assassin1th/BluetoothDecoder/device_board/plate/device_plate.step

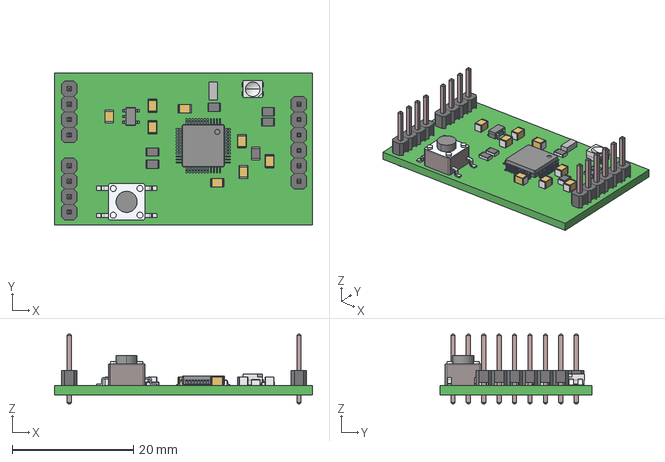
[picture p26: CAD file, 2020-04-22]
device_board/plate/device_plate.step
42.5 x 25.0 x 11.5 mm
