assassin1th/BluetoothDecoder/device_board/pattern/print_version.docx

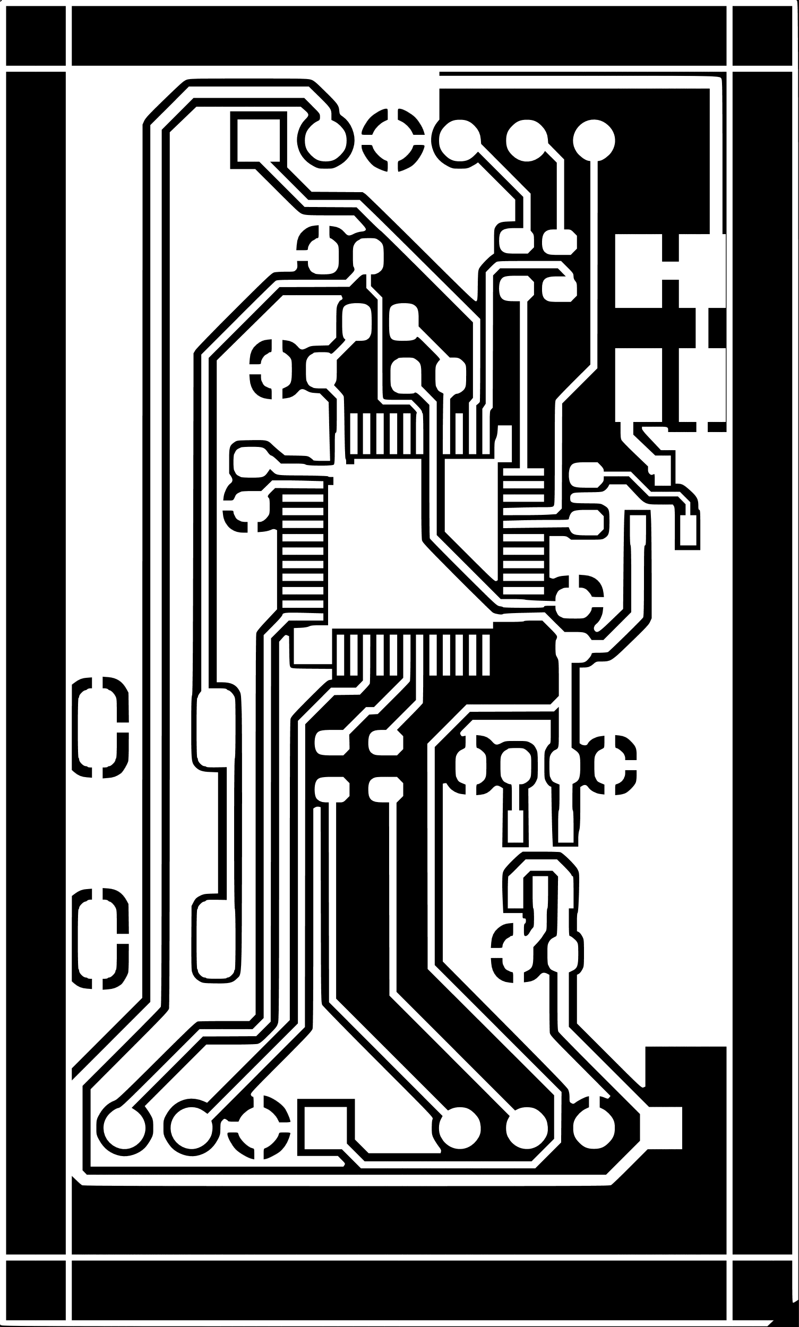
[picture p27: figure]
