assassin1th/BluetoothDecoder/documentation/drawings/Э3.pdf

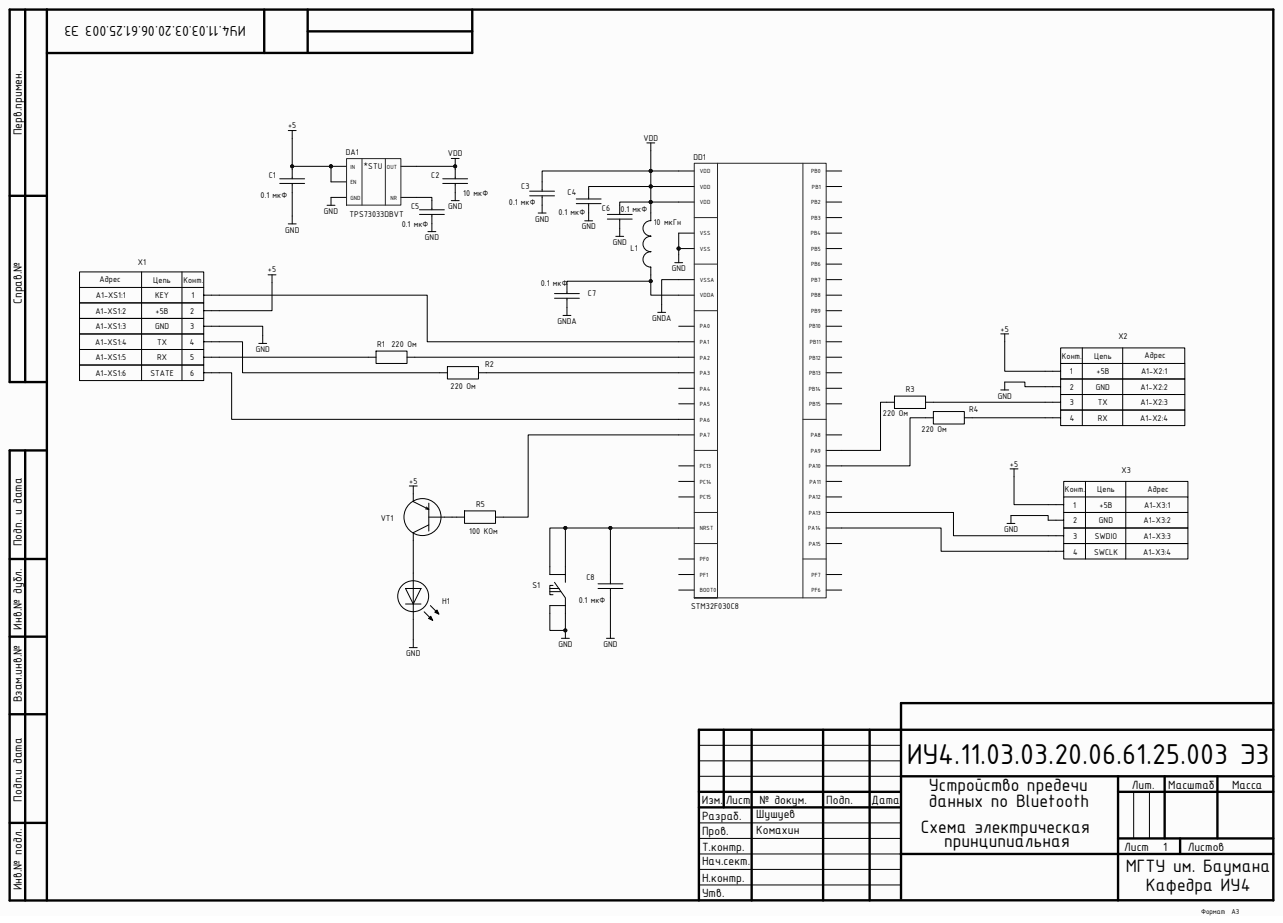
[picture p28: page 1]

Формат A3 Справ.№ Перв.примен.

A1-XS1:1 | KEY | 1
A1-XS1:2 | +5В | 2
A1-XS1:3 | GND | 3
A1-XS1:4 | TX | 4
A1-XS1:5 | RX | 5

2 | GND | A1-X2:2
3 | TX | A1-X2:3
4 | RX | A1-X2:4

Инв.№ подл. Подп.и дата Взам.инв.№ Инв.№ дубл. Подп. и дата

3 | SWDIO | A1-X3:3
4 | SWCLK | A1-X3:4

Устройство предечи данных по Bluetooth Схема электрическая принципиальная | Лит. | Масштаб | Масса

Изм. | Лист | № докум. | Подп. | Дата
Разраб. | | Шушуев
Пров. | | Комахин
Т.контр. | | | | | Лист 1 | Листов
Нач.сект. | | | | | МГТУ им. Баумана Кафедра ИУ4
Н.контр.
Утв.
