assassin1th/BluetoothDecoder/documentation/drawings/Algoritm_PO.pdf

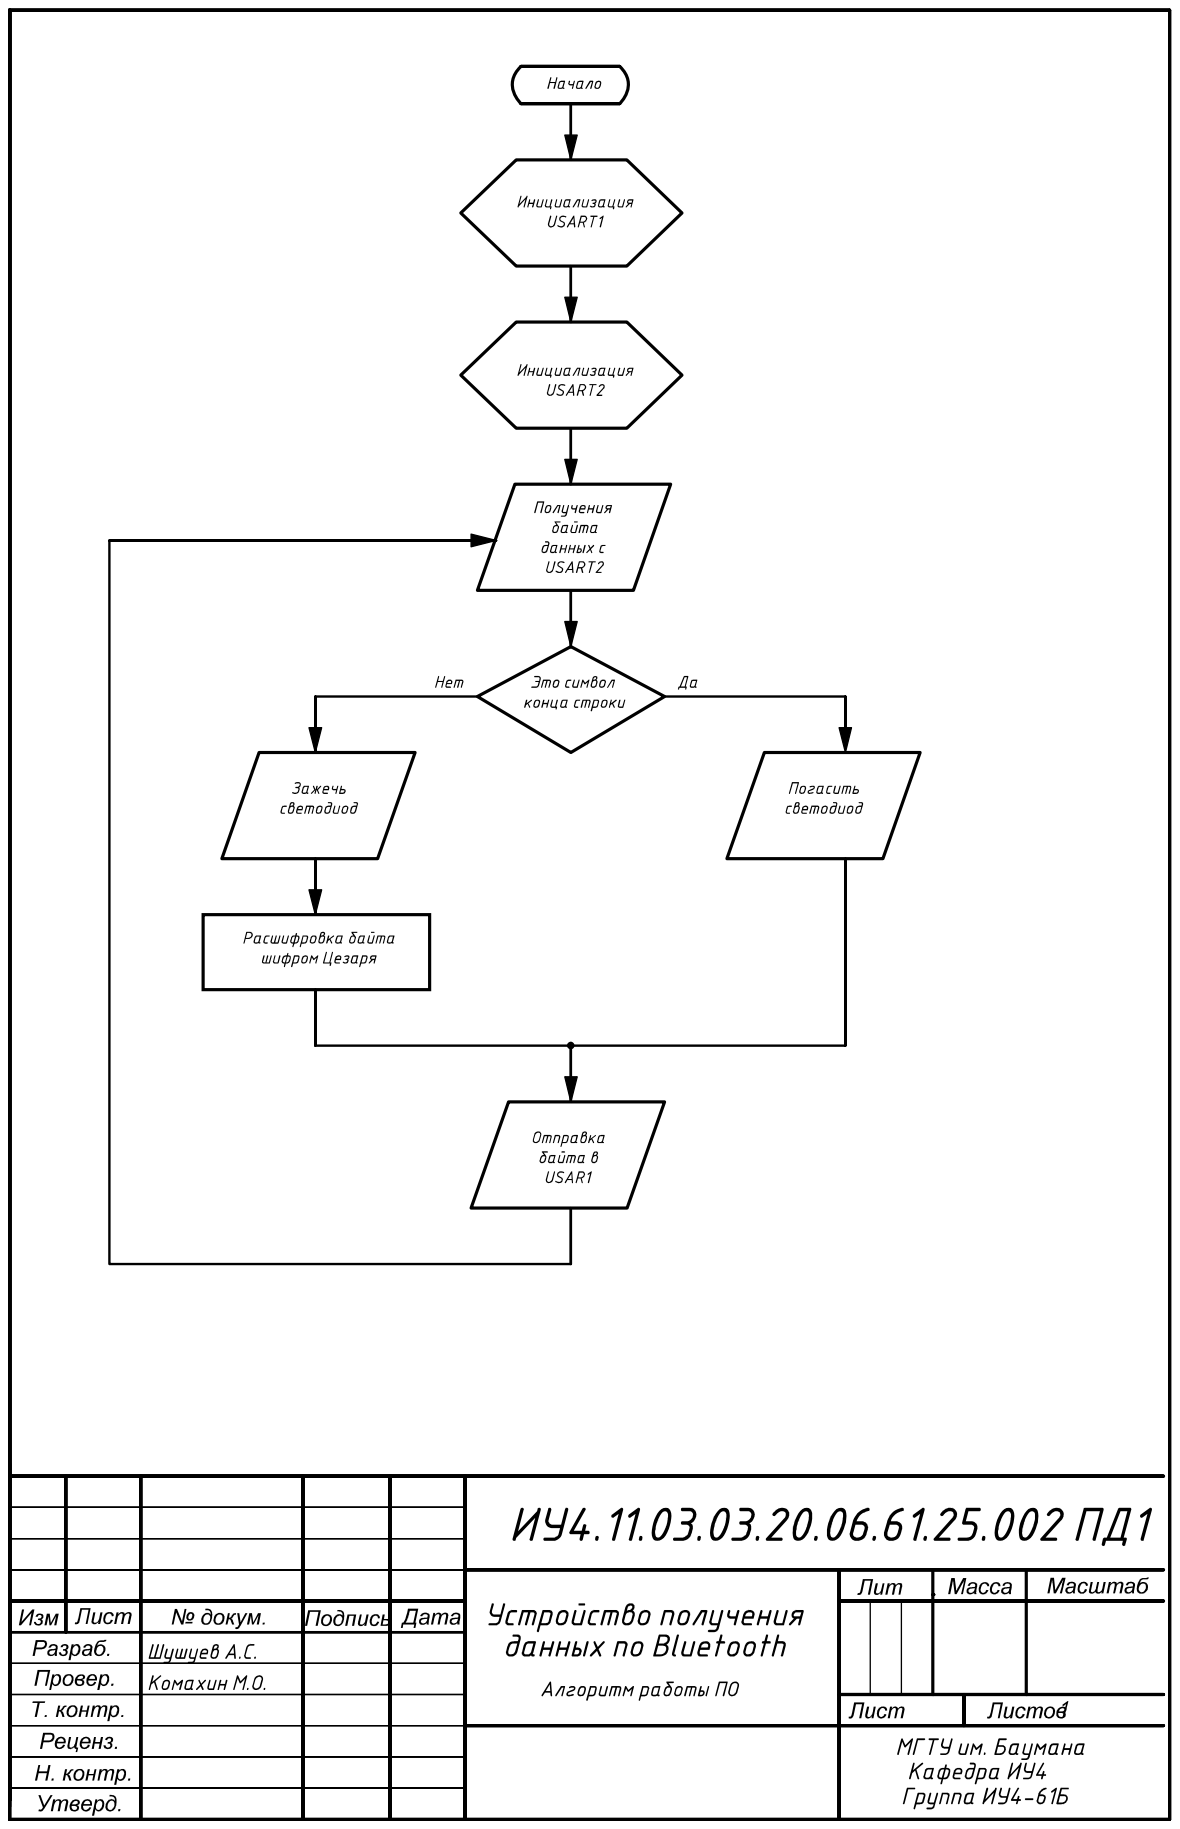
[picture p29: page 1]
