assassin1th/BluetoothDecoder/documentation/drawings/Algoritm_raboty_ustroystva.pdf

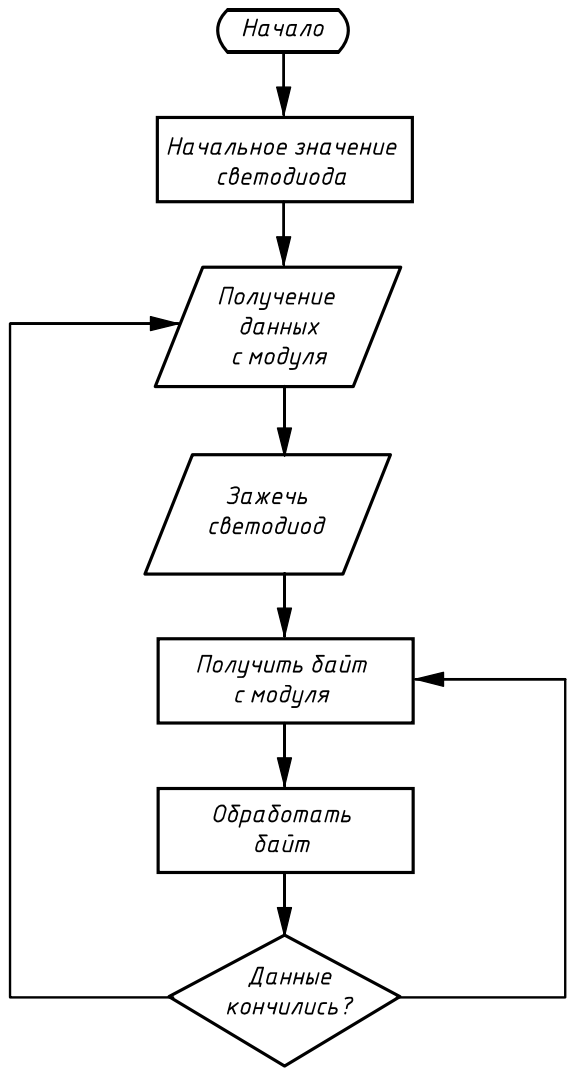
[picture p30: page 1]
