assassin1th/BluetoothDecoder/documentation/drawings/Skhema_stenda.pdf

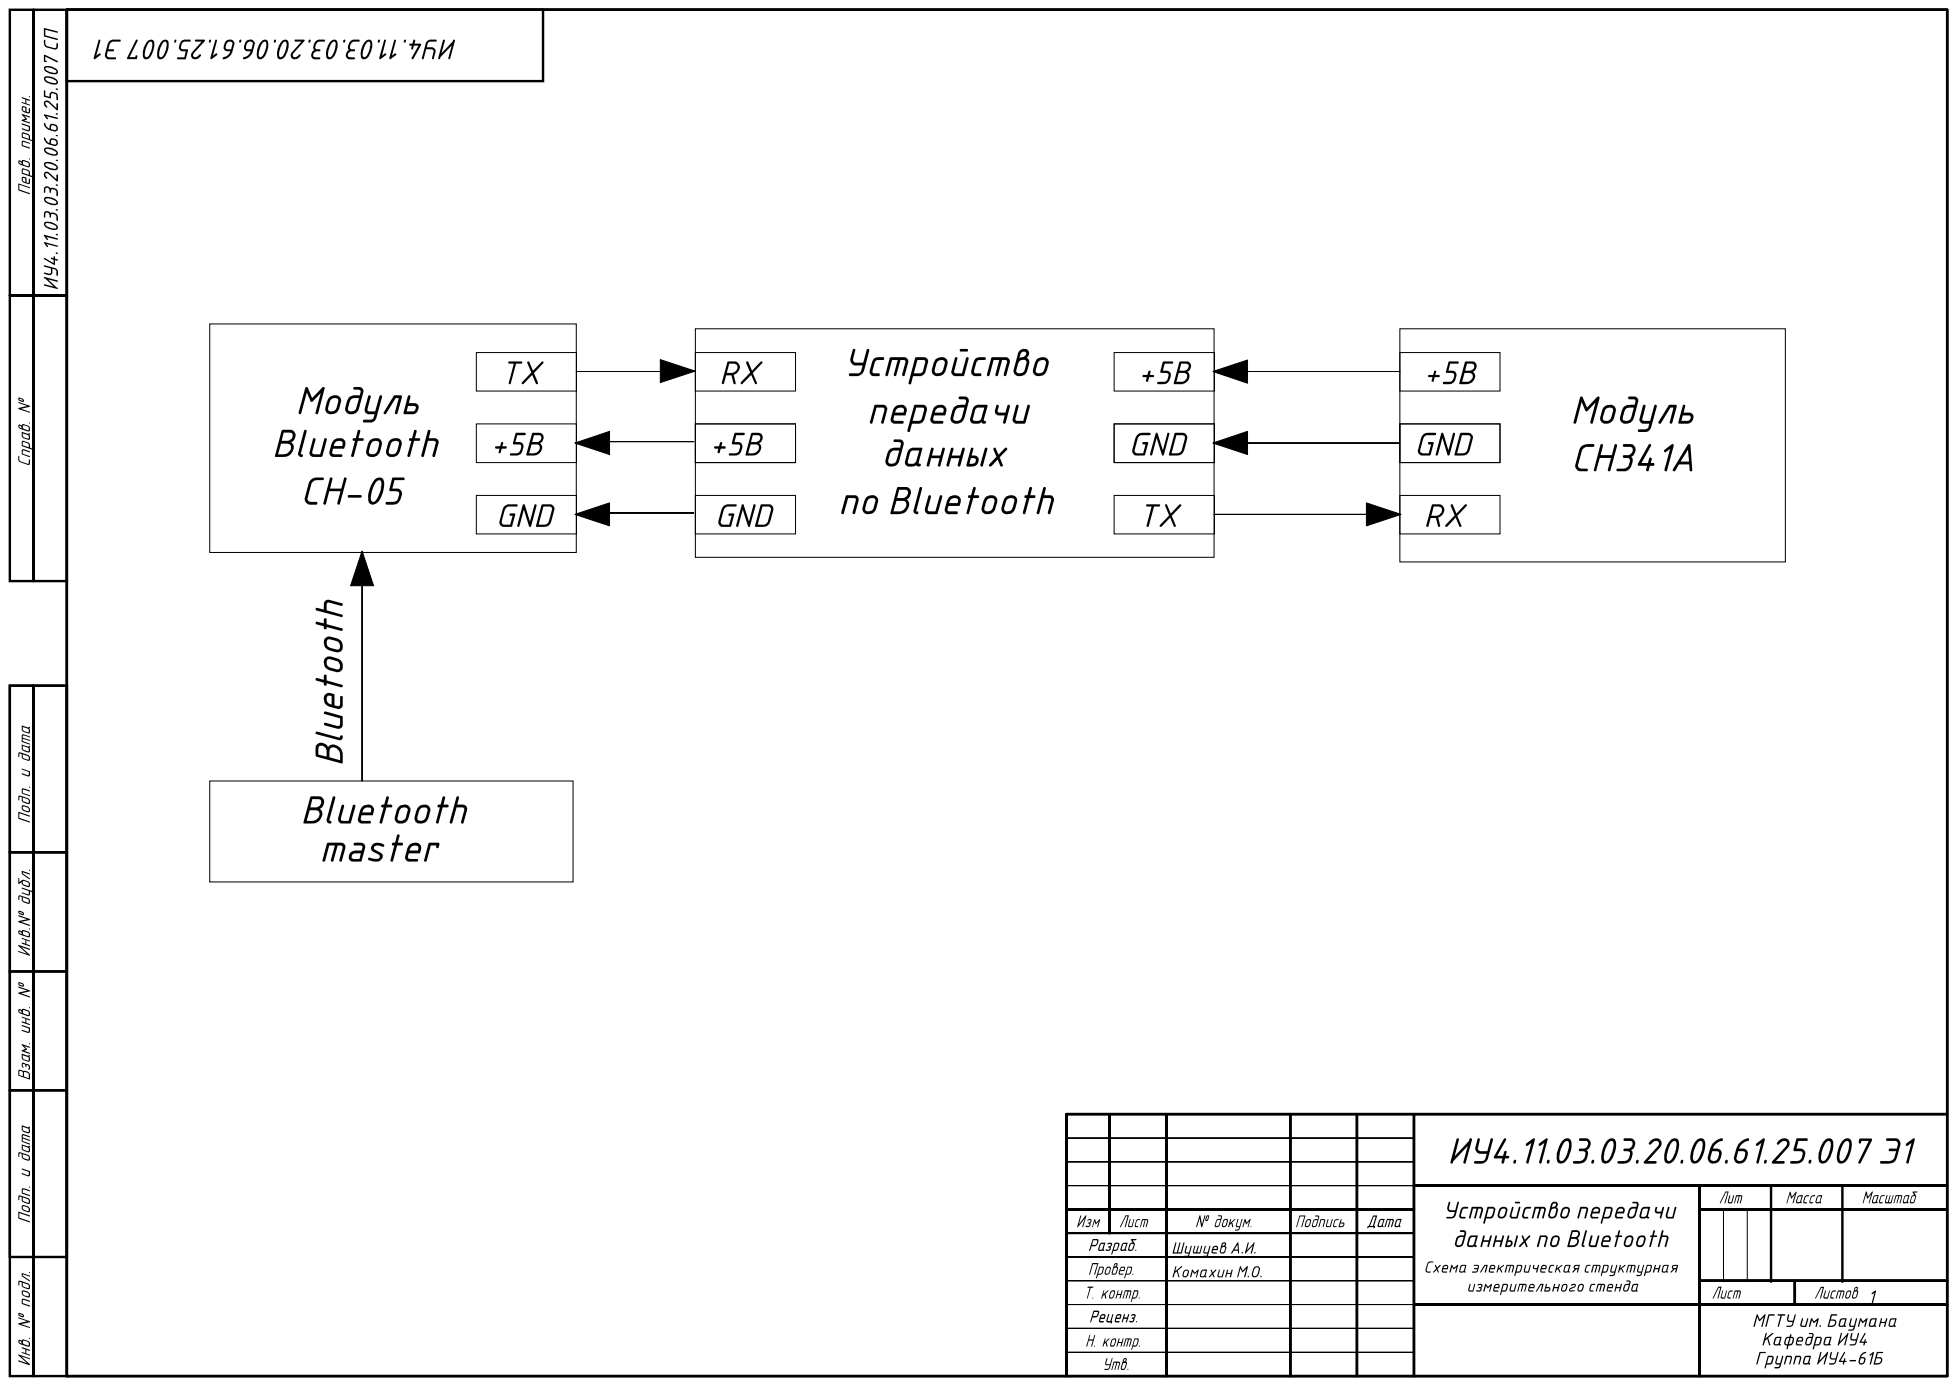
[picture p31: page 1]
