assassin1th/BluetoothDecoder/documentation/drawings/ПЭЗ.pdf

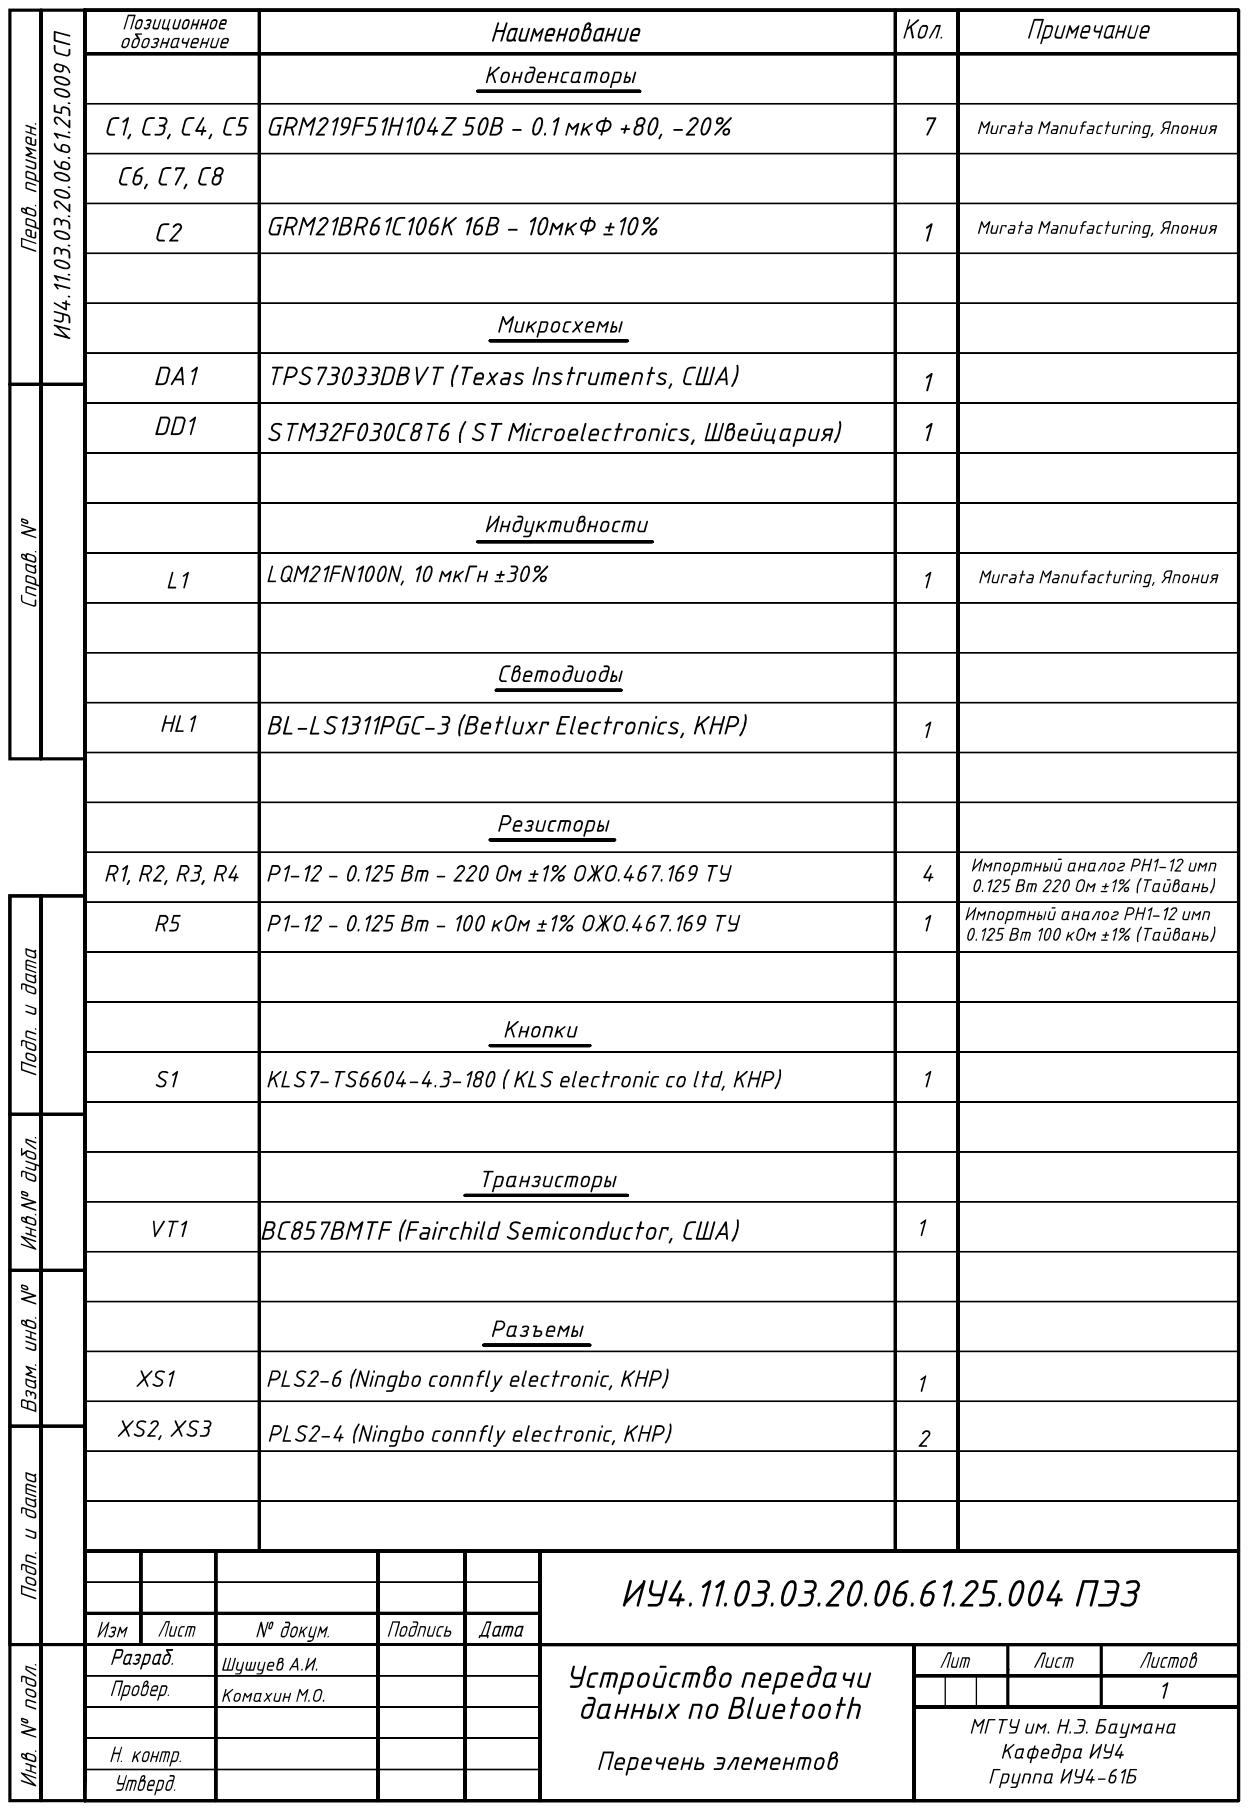
[picture p32: page 1]
