assassin1th/BluetoothDecoder/documentation/drawings/СП2.pdf

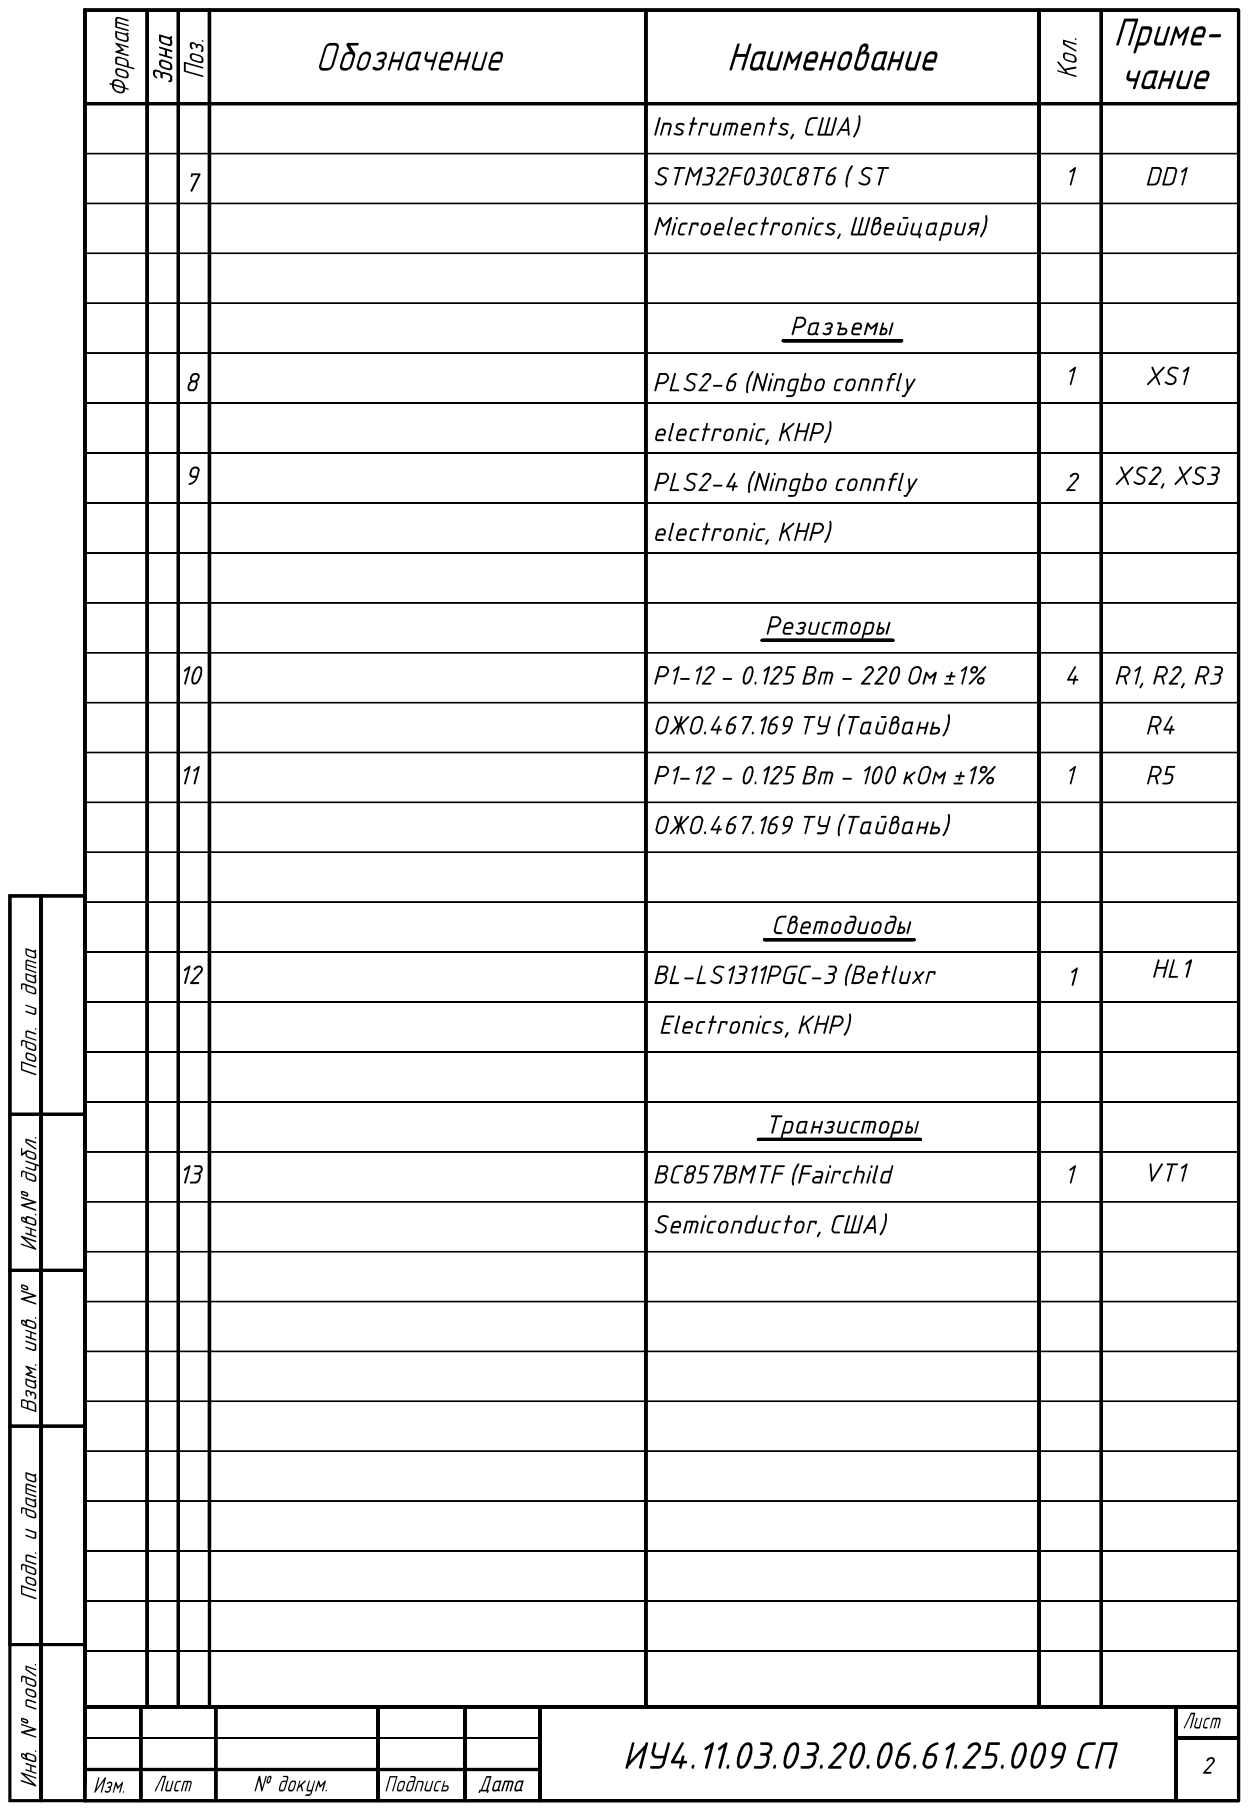
[picture p33: page 1]
