assassin1th/BluetoothDecoder/documentation/drawings/СП1.pdf

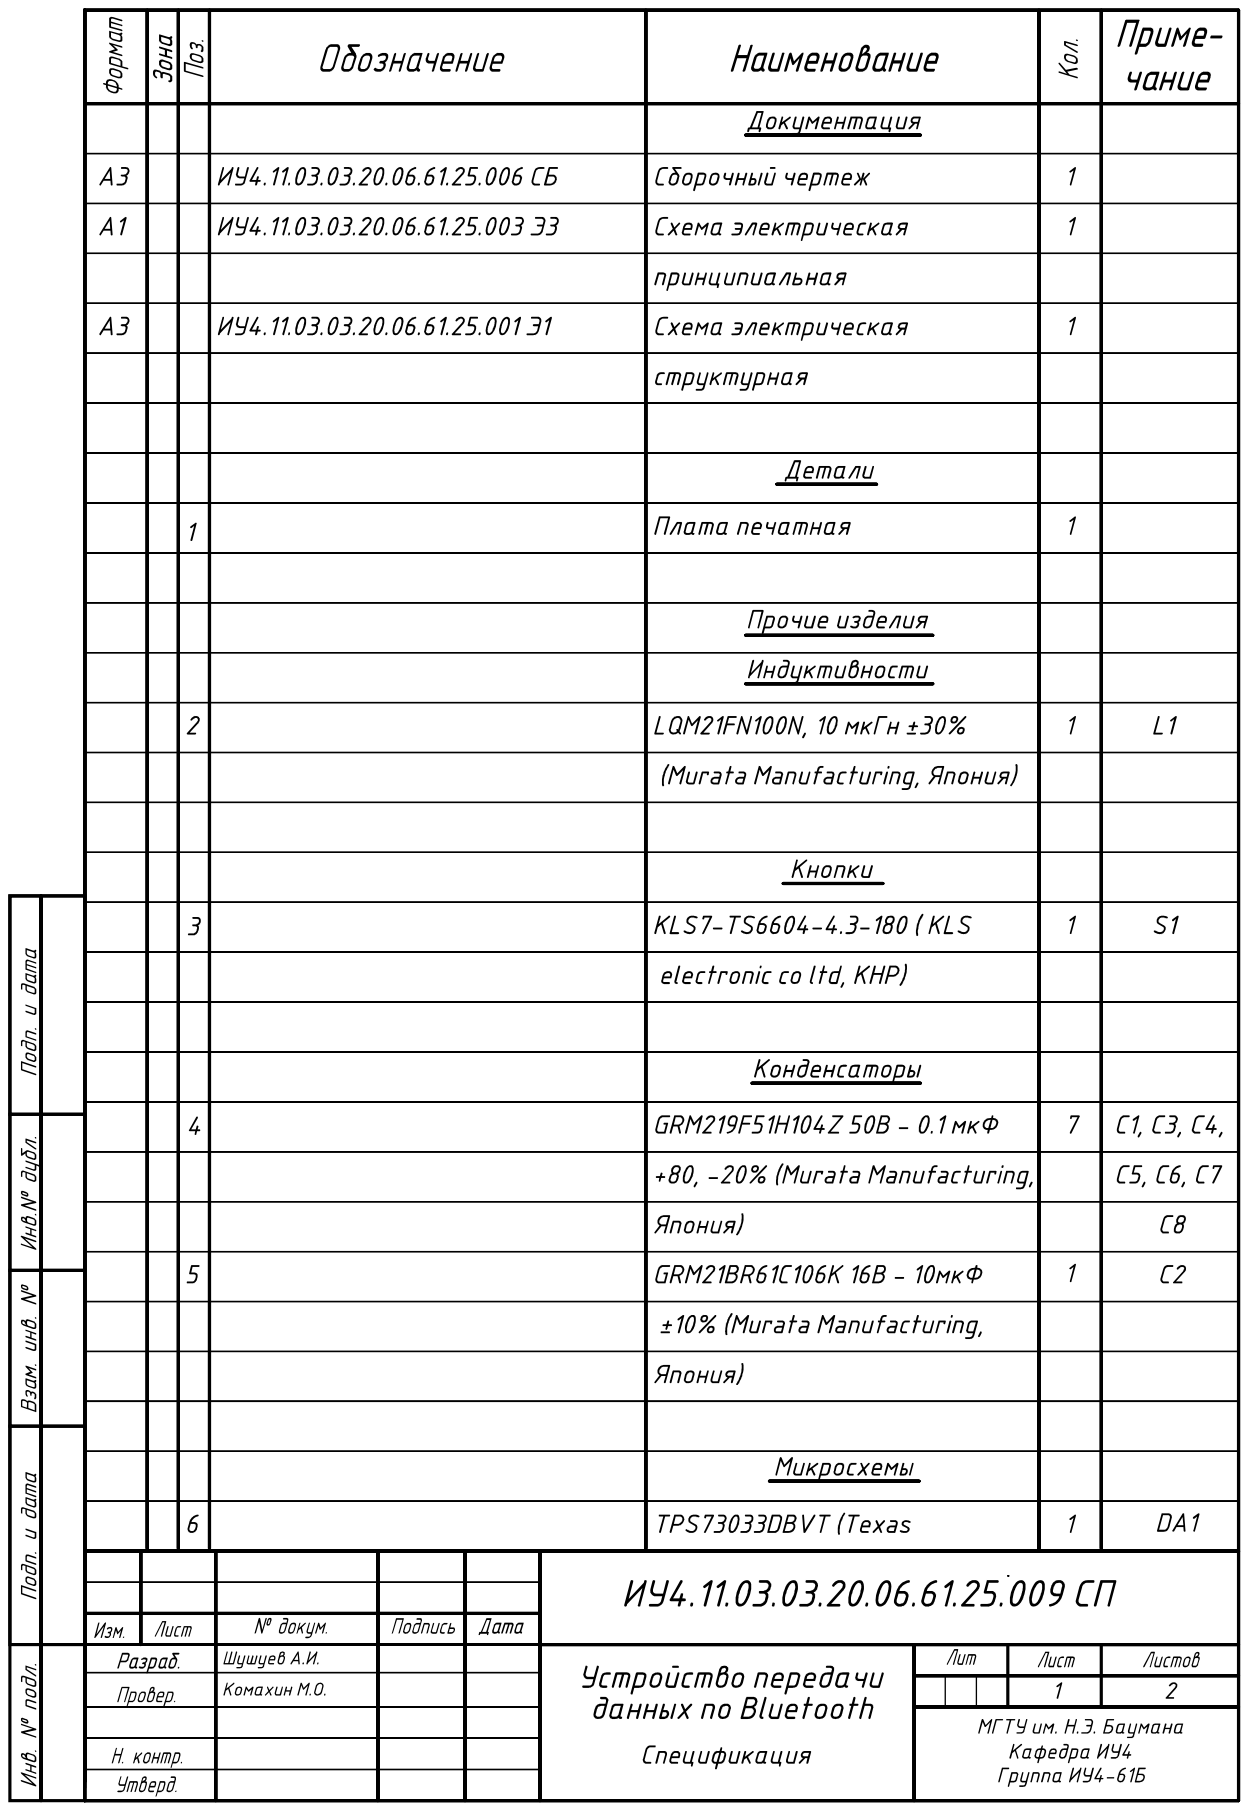
[picture p34: page 1]
