assassin1th/BluetoothDecoder/documentation/drawings/Э1.pdf

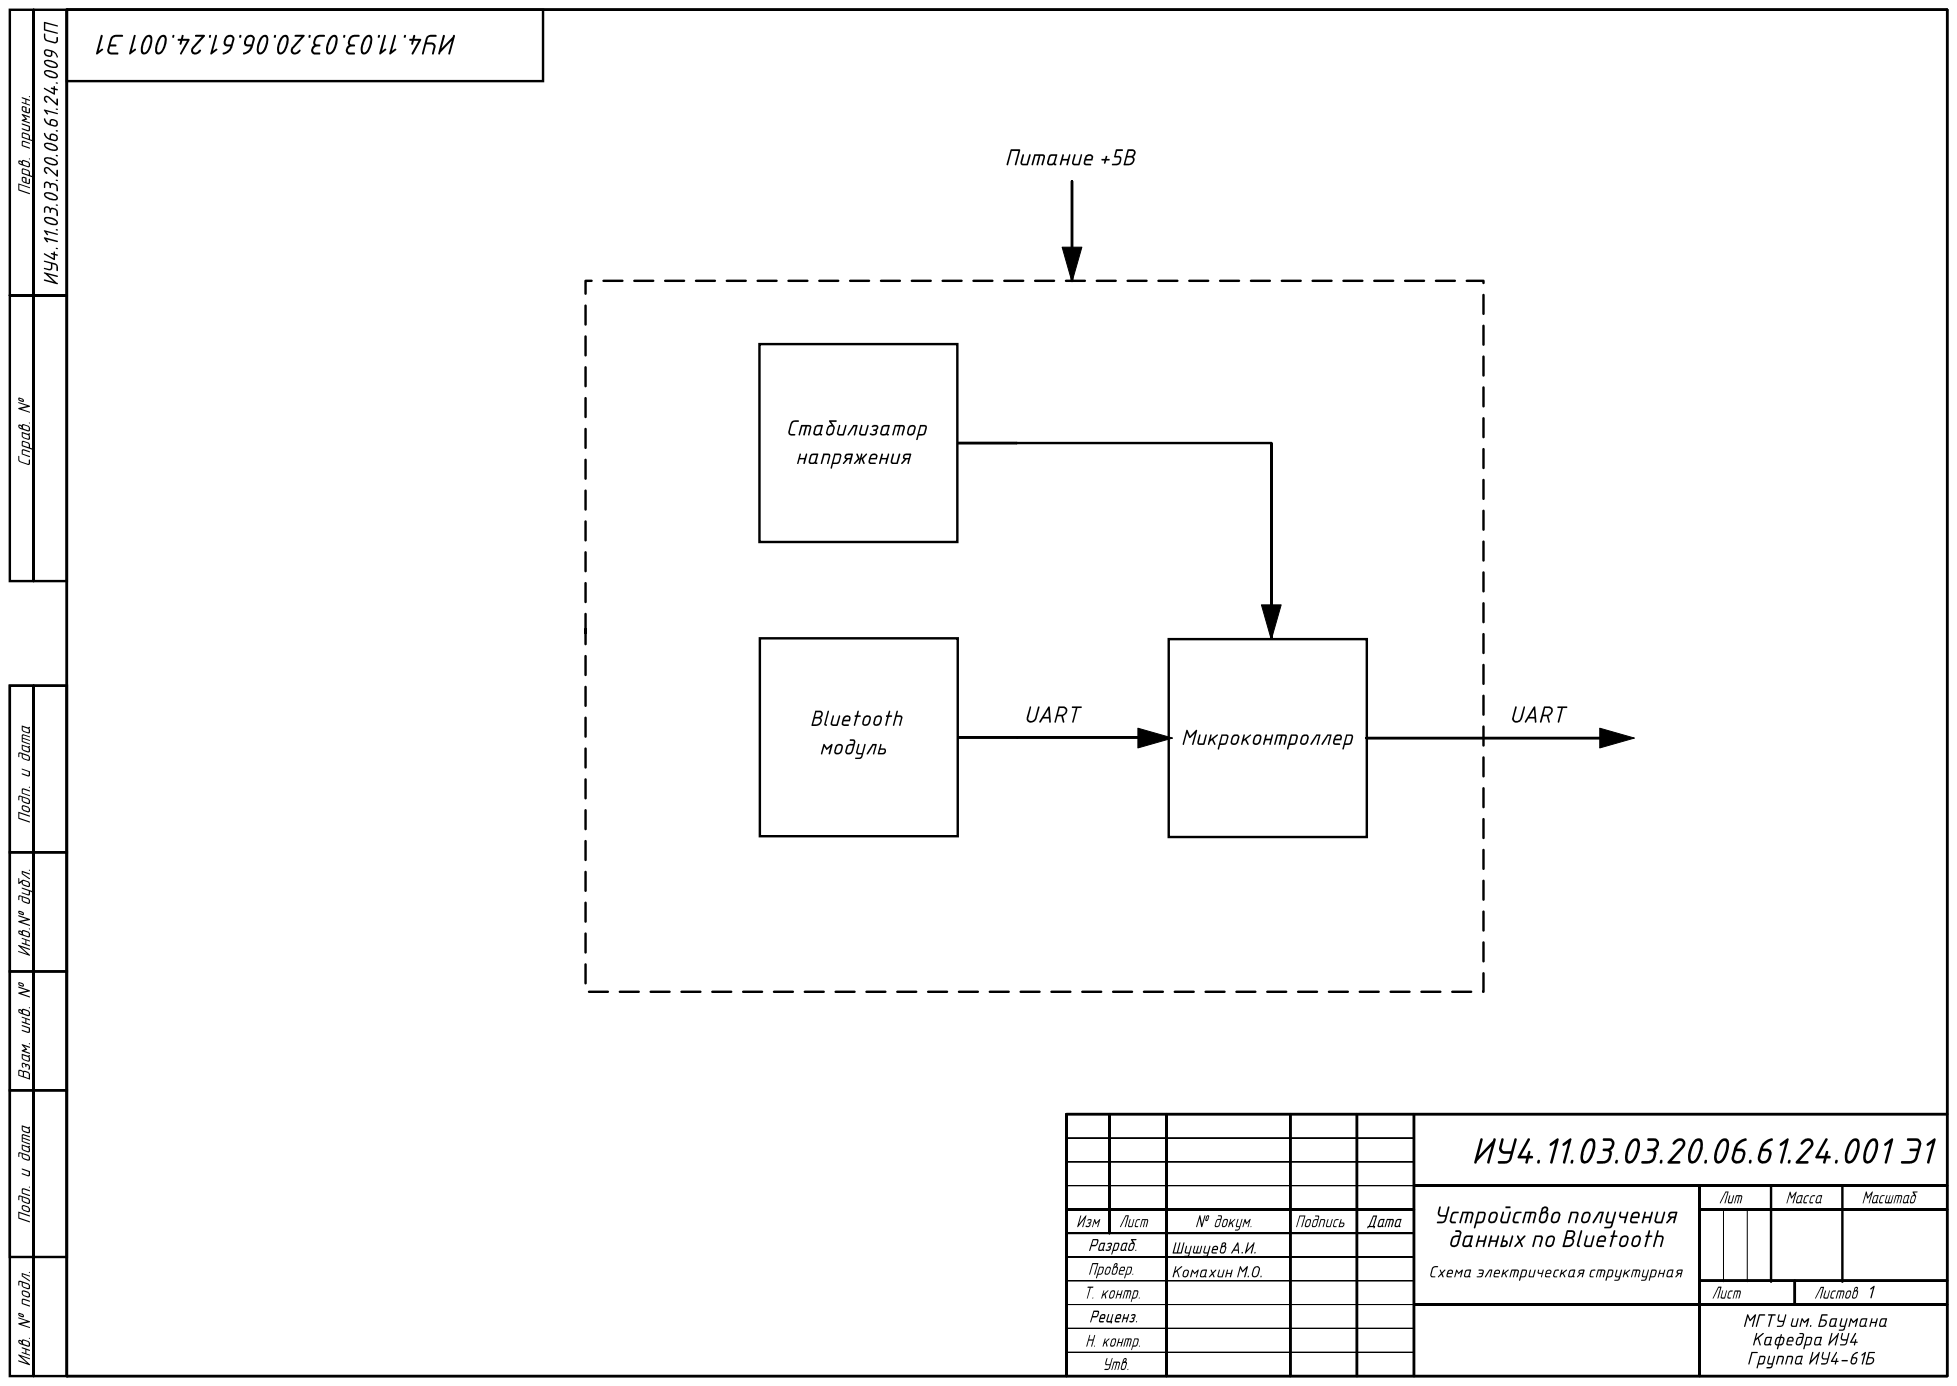
[picture p35: page 1]
