assassin1th/BluetoothDecoder/(list of files, drawings)

Other design files:
device_board/bluetooth_decoder.PrjPCB
device_board/plate/device_plate.PcbDoc
device_board/plate/mask.PcbDoc
simulation/DIODE.DSN
simulation/diode.opj
