assassin1th/BluetoothDecoder/(commit log)

2020-03-14 end demo version of device schem
    [bluetooth_decoder.PrjPCB, device_plate.PcbDoc]
2020-03-15 add plate trace
    [device_plate.PcbDoc]
2020-03-24 feat(drawings): add э1 drawing
2020-04-22 feat (Э3): э3 drawing added
    [bluetooth_decoder.PrjPCB, device_plate.PcbDoc, device_plate.step, mask.PcbDoc]
2020-05-11 feat (documentation): added new drawings
    [bluetooth_decoder.PrjPCB, device_plate.PcbDoc, mask.PcbDoc]
2020-05-12 feat (documentation): ПЭЗ added
2020-06-02 feat (firmware): store firmware
    [DIODE.DSN, bluetooth_decoder.PrjPCB, device_plate.PcbDoc, diode.opj]
